ningyingzhi/Final-Project/reference/Screenshot 2026-10-26 at 2.33.02 PM.png

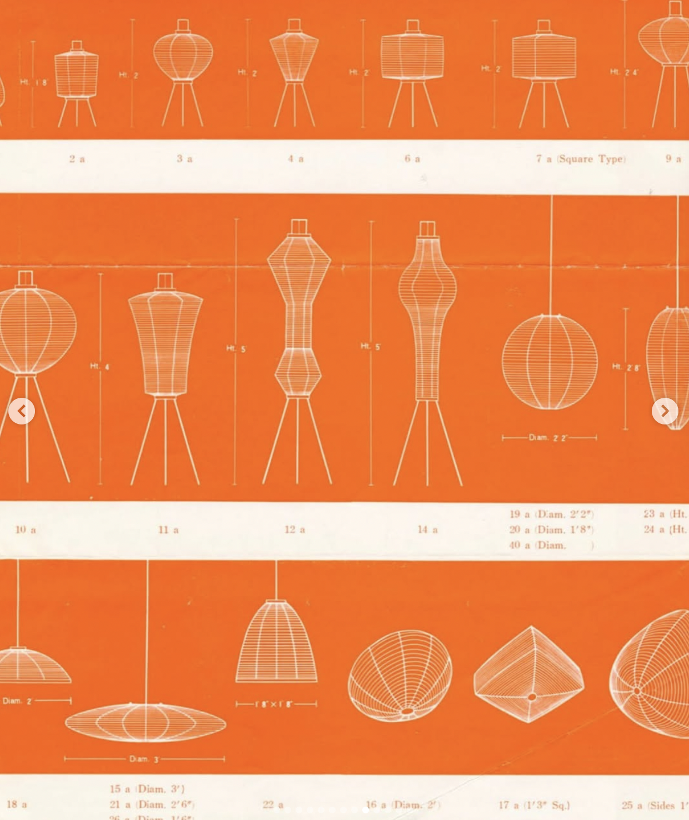
reference/Screenshot 2026-10-26 at 2.33.02 PM.png
