ningyingzhi/Final-Project/reference/09-Brancusi_HART-Museum_Foto-Aad-Hoogendoorn-1024x683.jpg

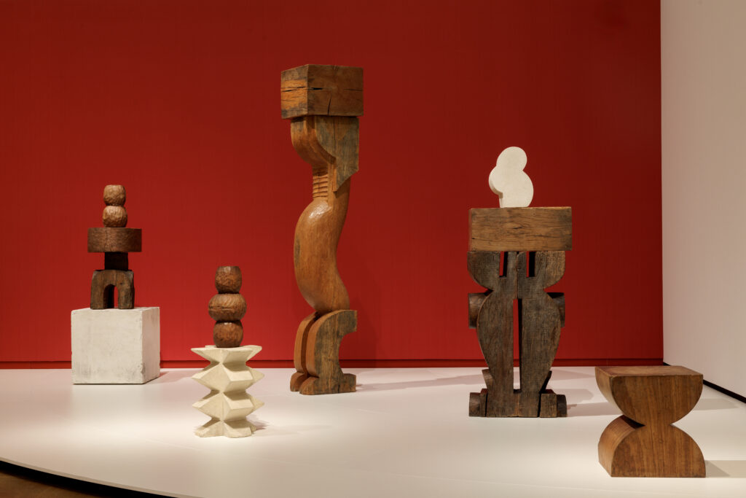
reference/09-Brancusi_HART-Museum_Foto-Aad-Hoogendoorn-1024x683.jpg
