ningyingzhi/Final-Project/reference/22cul-brancusi-notebook-15-vkgh-videoSixteenByNine3000.webp

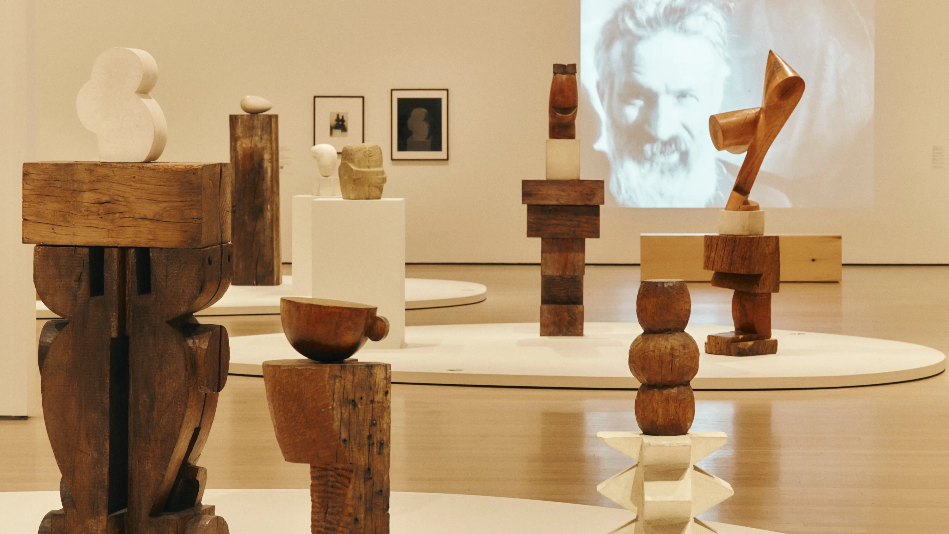
reference/22cul-brancusi-notebook-15-vkgh-videoSixteenByNine3000.webp
