ningyingzhi/Final-Project/reference/314069a723647cfc95809f75b9e9e8bd.jpg

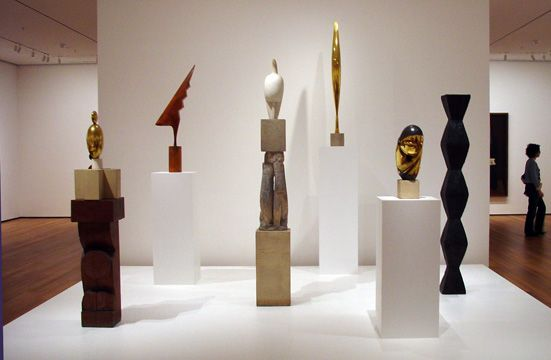
reference/314069a723647cfc95809f75b9e9e8bd.jpg
