ningyingzhi/Final-Project/reference/a63931717c4ae1370eb8c31e62e9cae8.jpg

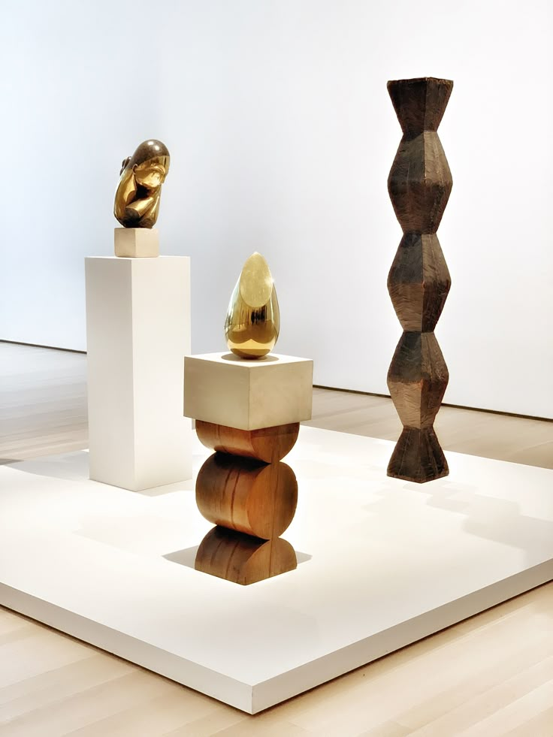
reference/a63931717c4ae1370eb8c31e62e9cae8.jpg
