ningyingzhi/Final-Project/reference/brancusi.jpg

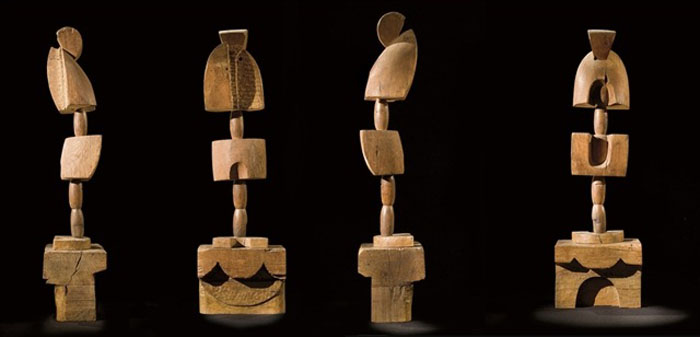
reference/brancusi.jpg
