ningyingzhi/Final-Project/reference/images.jpg

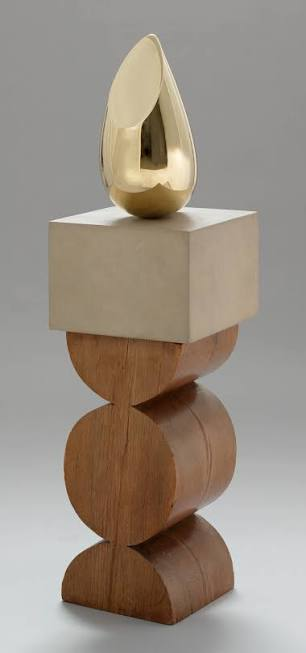
reference/images.jpg
