ningyingzhi/Final-Project/reference/Screenshot 2026-10-26 at 2.35.59 PM.png

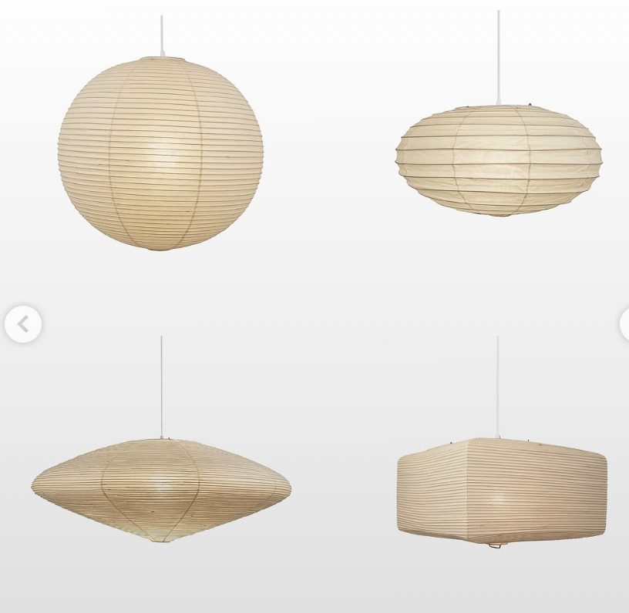
reference/Screenshot 2026-10-26 at 2.35.59 PM.png
