ningyingzhi/Final-Project/sketches/concept_watercolor_v1.png

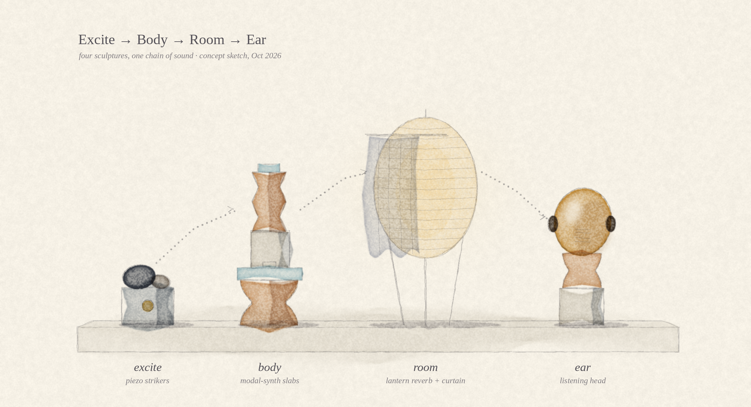
sketches/concept_watercolor_v1.png
