ningyingzhi/Final-Project/sketches/concept_watercolor_v2_magnetic.png

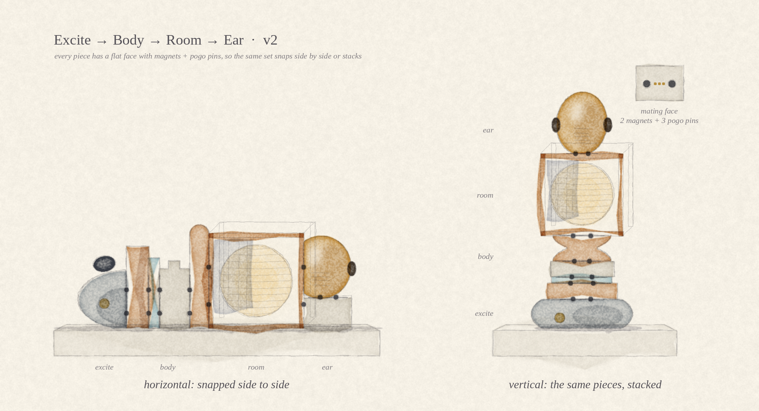
sketches/concept_watercolor_v2_magnetic.png
