ningyingzhi/Final-Project/sketches/concept_watercolor_v4_slim.png

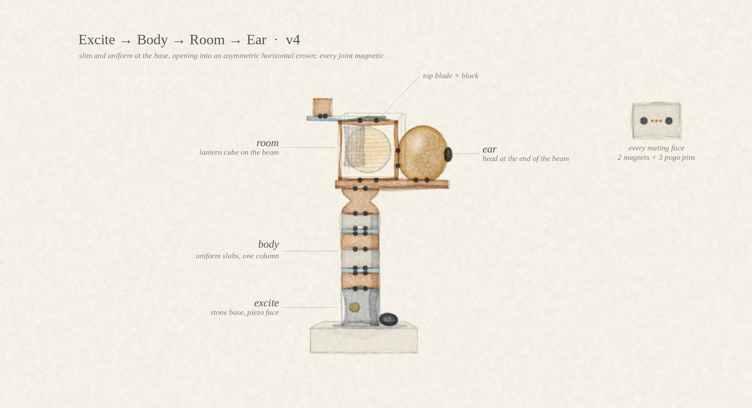
sketches/concept_watercolor_v4_slim.png
