ningyingzhi/Final-Project/sketches/module_connections_v1.png

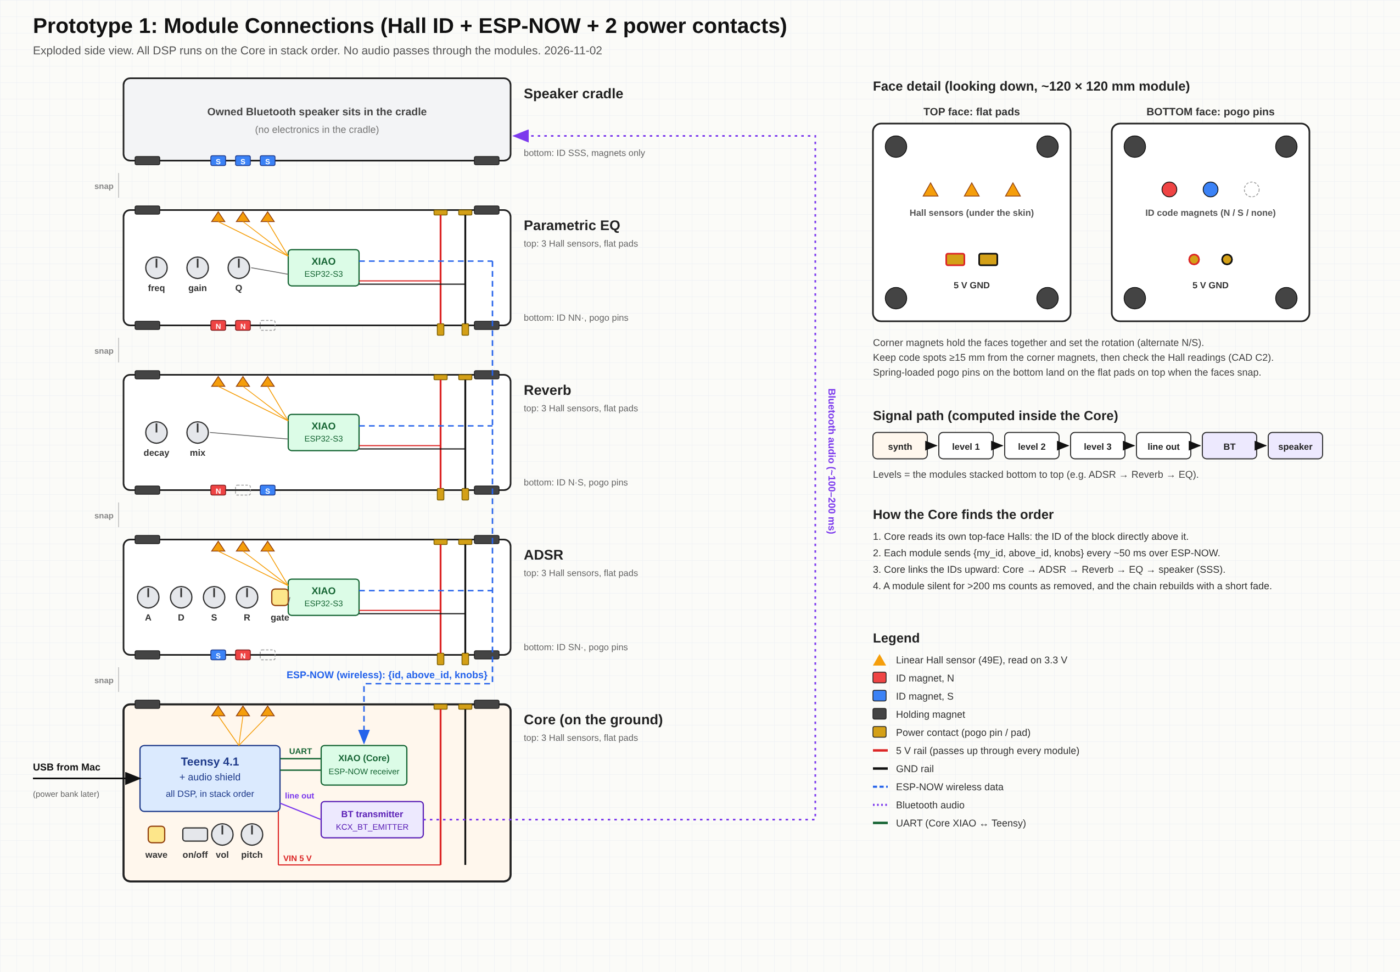
sketches/module_connections_v1.png
