ningyingzhi/Final-Project/sketches/reference_board.jpg

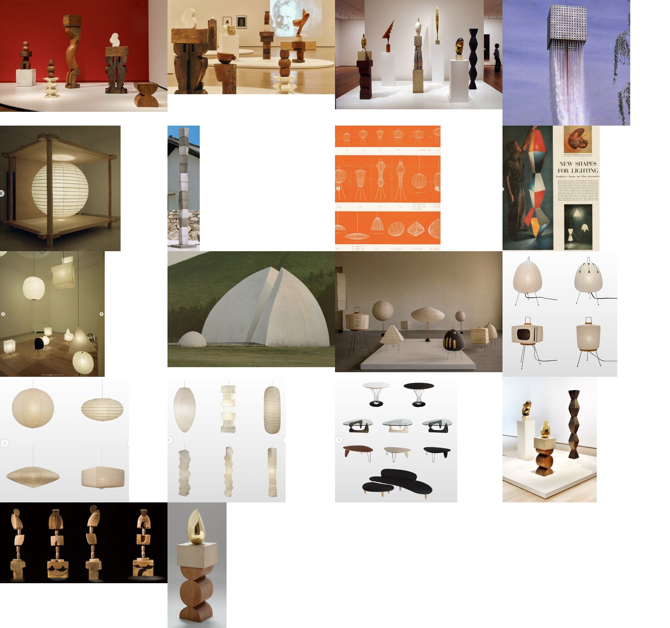
sketches/reference_board.jpg
