ningyingzhi/Final-Project/sketches/concept_watercolor_v3_assemblage.png

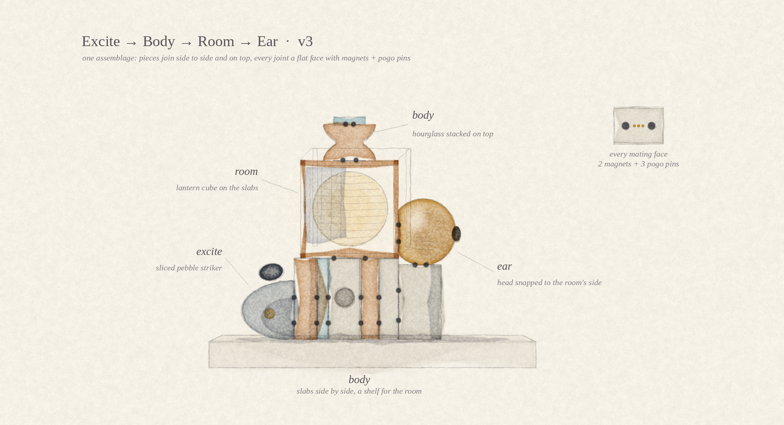
sketches/concept_watercolor_v3_assemblage.png
