ningyingzhi/Final-Project/sketches/hall_face_test_v1.png

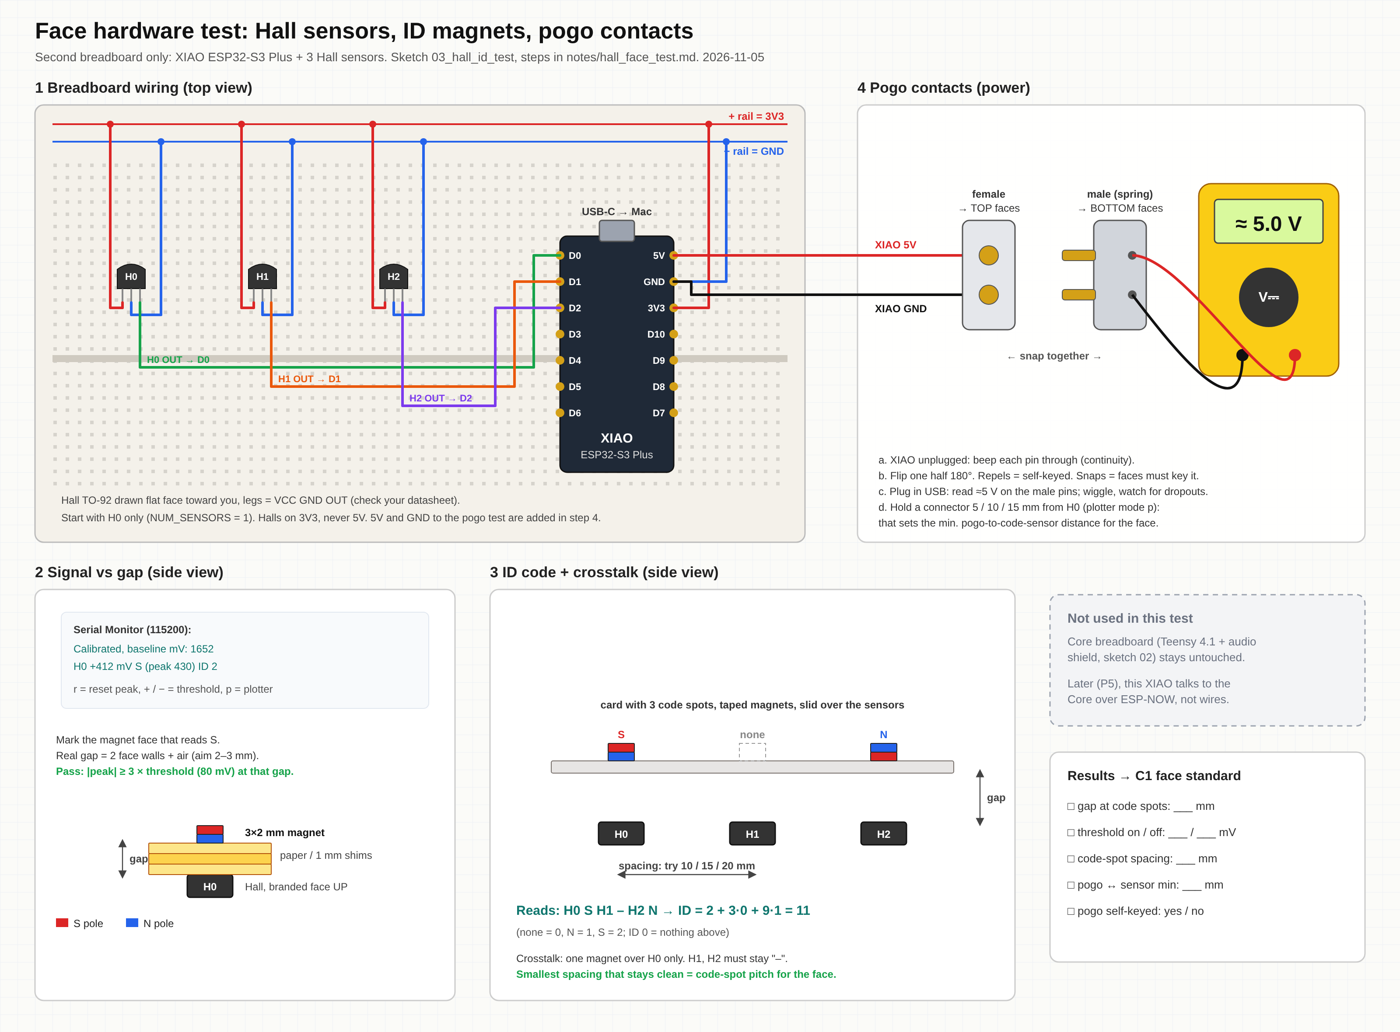
sketches/hall_face_test_v1.png
