ningyingzhi/Final-Project/sketches/hall_link_test_v1.png

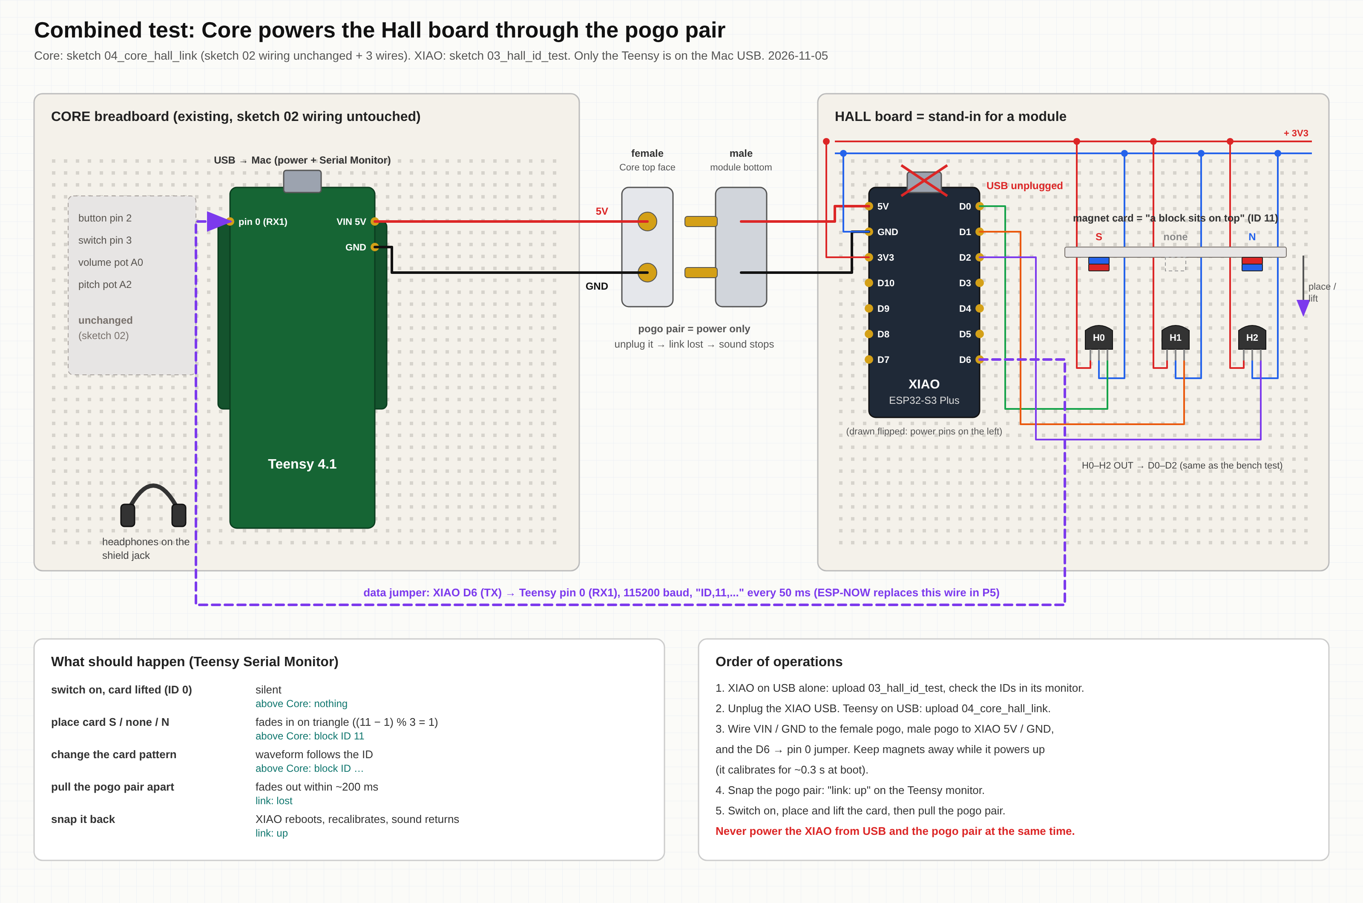
sketches/hall_link_test_v1.png
