ningyingzhi/Final-Project/PROJECT_LOG.md

# Project Log

Status of each `plan.md` step (CLAUDE.md rule 11). Status key: ✅ done (tested) · 🟡 in progress · ⬜ not started.
The previous log is in `notes/archive/PROJECT_LOG_2026-10-30.md`.

## Prototype 1: DSP
| Step | Status | Date | By | Sketch / file | Notes |
|---|---|---|---|---|---|
| P1 First sound | ✅ | 2026-10-30 | Allen | `sketches/01_first_sound` | 440 Hz sine on headphones, CPU/memory on Serial |
| P2 Synth engine | ✅ | 2026-10-30 | Allen | `sketches/02_waveform_osc` | Button cycles 3 waveforms, switch fades on/off, volume pot (A0, dB) and pitch pot (A2, 55–1760 Hz exp) tested |
| P3 Effects on breadboard | ⬜ | | | | ADSR + reverb + EQ, fixed order |
| P4 Reorderable chain | ⬜ | | | | |
| P5 Module link (Hall ID + ESP-NOW) | ⬜ | | | | |
| P6 Standalone (speaker + power bank) | ⬜ | | | | Bluetooth transmitter module in the Core (to buy) |

## Prototype 1: CAD
| Step | Status | Date | By | Notes |
|---|---|---|---|---|
| C1 Face standard | ⬜ | | | |
| C2 Test face pair | ⬜ | | | |
| C3 Shells (Core, 3 effects, speaker cradle) | ⬜ | | | |
| C4 Final | ⬜ | | | |
