ningyingzhi/Final-Project/(commit log)

2026-11-05 Add Hall ID test sketch and face hardware test steps
    03_hall_id_test reads 3 linear Hall sensors, classifies N/S/none with
    hysteresis and prints the base-3 ID. notes/hall_face_test.md has the
    bench steps for thresholds, gap, crosstalk and the pogo connectors.
    Claude-Session: https://claude.ai/code/session_01TdizaNjrk5dJ6jeSFHH1CA
2026-11-05 Hall ID test: run on XIAO ESP32-S3 (D0-D2) as well as Teensy
    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
2026-11-05 Add combined Core + Hall board test (04_core_hall_link, XIAO UART report, diagram)
    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
